BlueBug12/Arduino_project/(commit log)

2021-02-18 new version with interrupt button
2022-09-17 SPI illustration
